RFingAdam/helium-weather-station/assets/DashboardMobile1.PNG

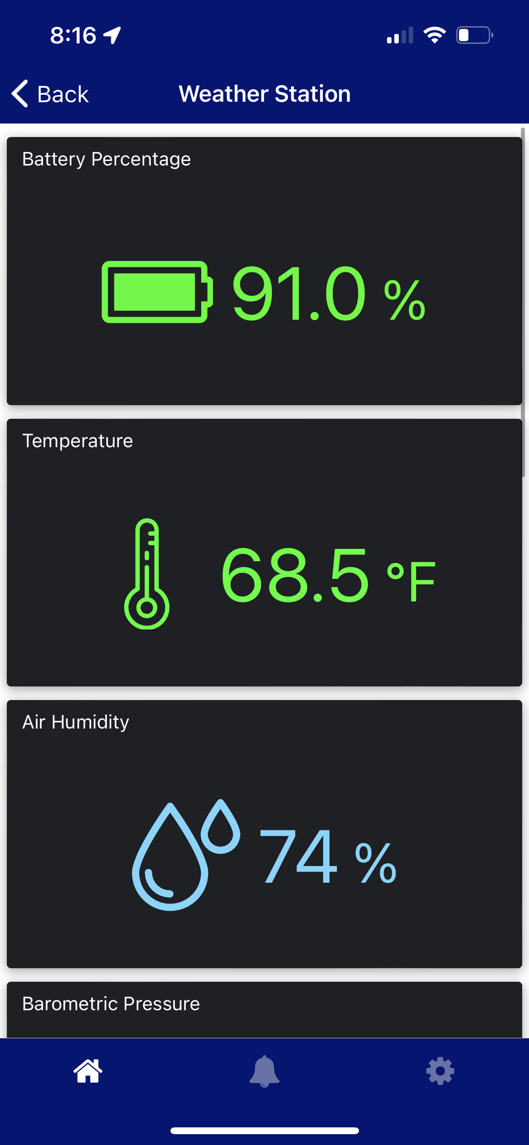
assets/DashboardMobile1.PNG
