RFingAdam/helium-weather-station/assets/DashboardMobile2.PNG

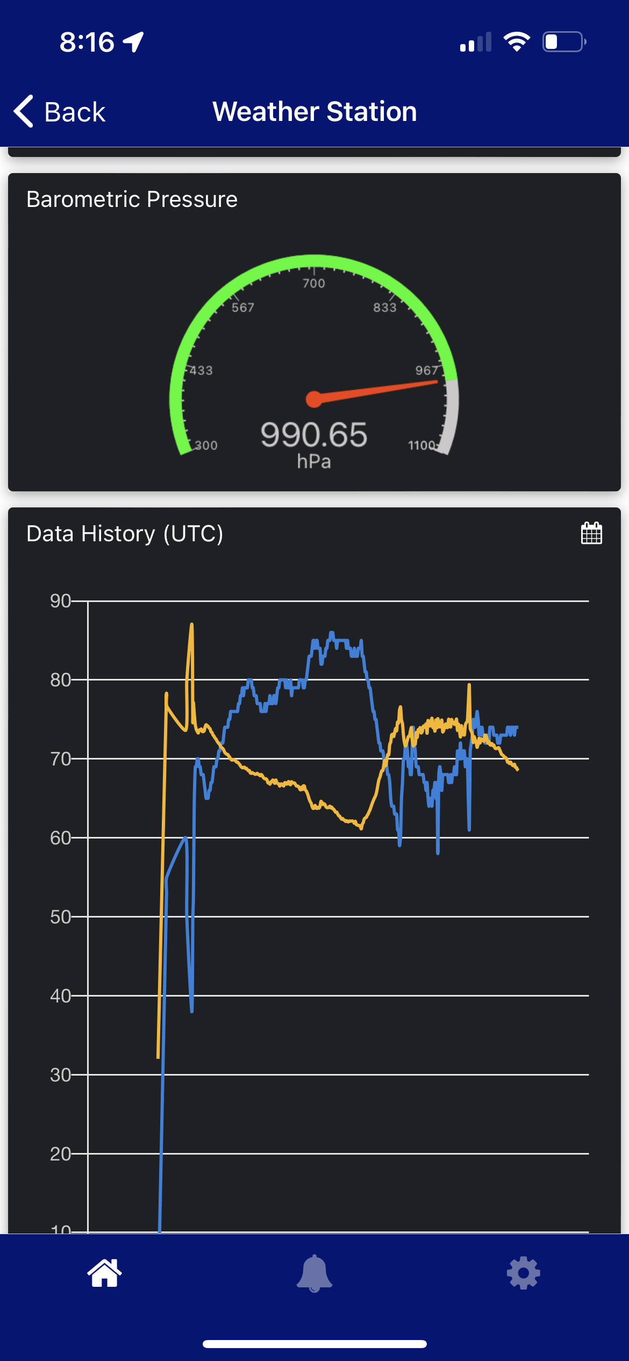
assets/DashboardMobile2.PNG
