RFingAdam/helium-weather-station/assets/finished (2).PNG

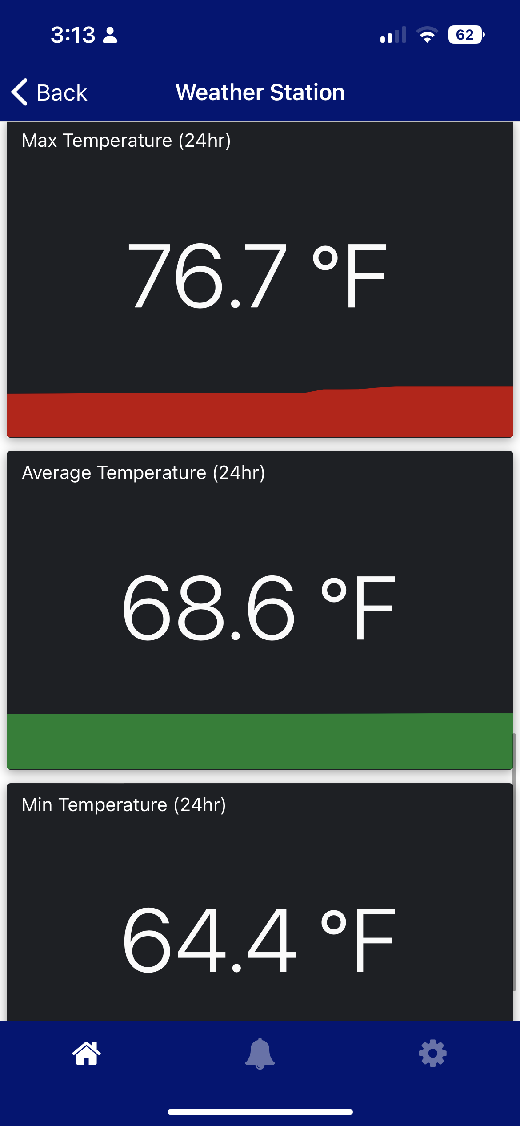
assets/finished (2).PNG
