RFingAdam/helium-weather-station/housing/mini-lora-ws-bracket.step

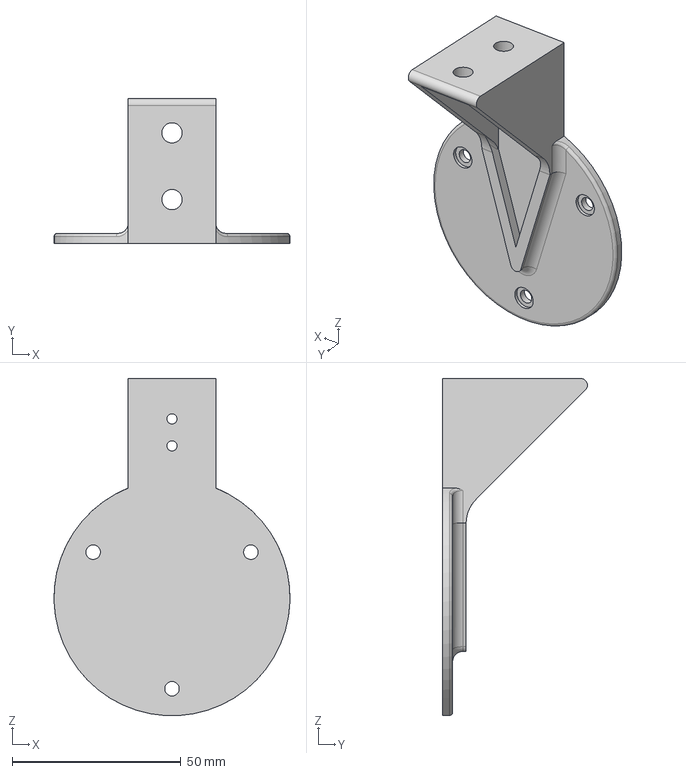
[picture p8: CAD file, 2024-08-08]
housing/mini-lora-ws-bracket.step
70.0 x 43.0 x 99.9 mm
