RFingAdam/helium-weather-station/housing/mini-lora-ws-closedlayer.step

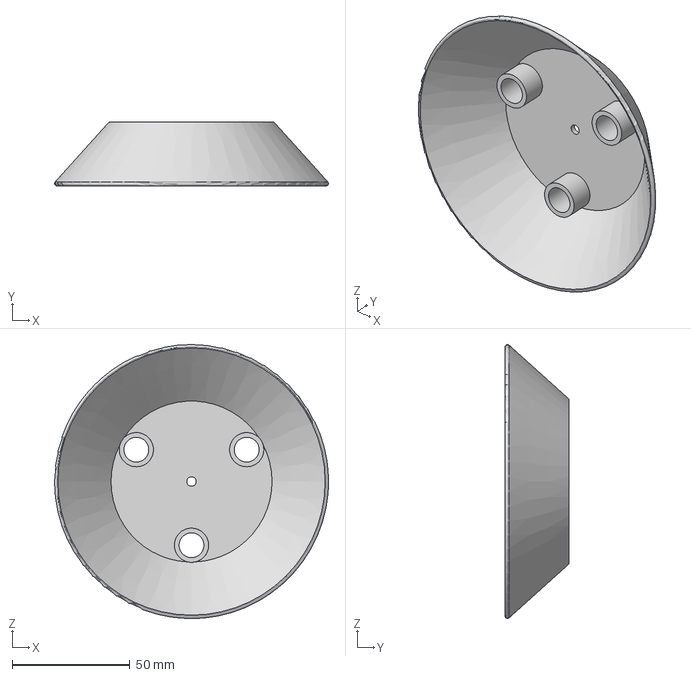
[picture p9: CAD file, 2024-08-08]
housing/mini-lora-ws-closedlayer.step
116.1 x 27.0 x 116.1 mm
