RFingAdam/helium-weather-station/housing/mini-lora-ws-openlayer.step

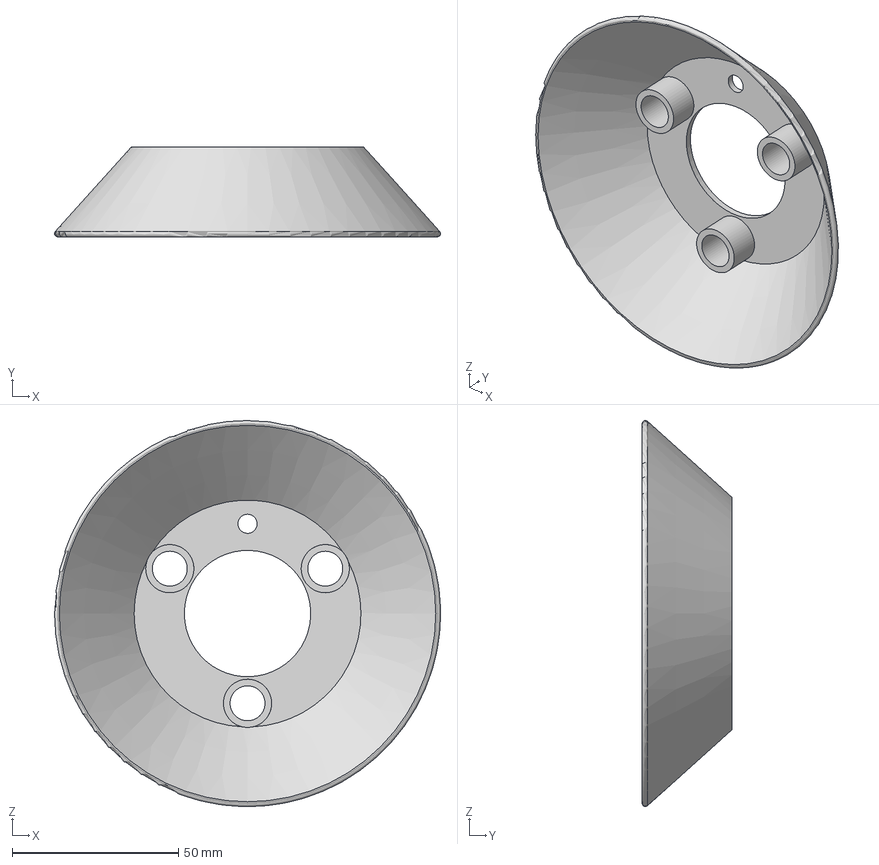
[picture p10: CAD file, 2024-08-08]
housing/mini-lora-ws-openlayer.step
116.1 x 27.0 x 116.1 mm
