RFingAdam/helium-weather-station/housing/mini-lora-ws-base.step

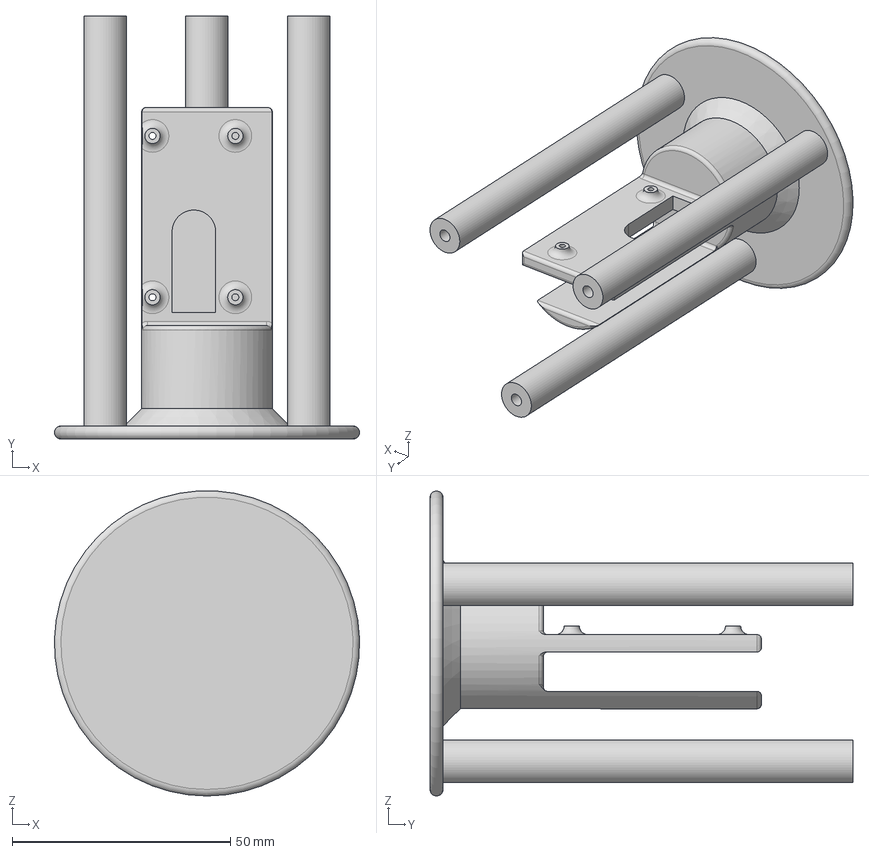
[picture p11: CAD file, 2024-08-08]
housing/mini-lora-ws-base.step
70.0 x 97.0 x 69.9 mm
