RFingAdam/helium-weather-station/housing/mini-lora-ws-solar.step

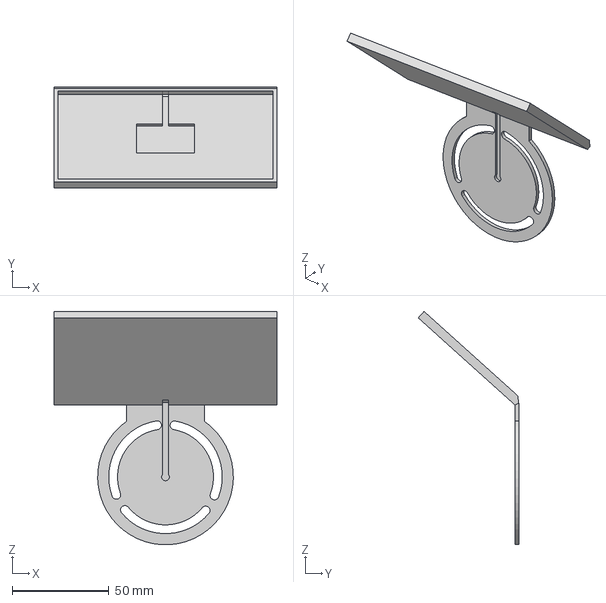
[picture p12: CAD file, 2024-08-08]
housing/mini-lora-ws-solar.step
115.0 x 51.9 x 120.3 mm
