RFingAdam/helium-weather-station/(list of files, cad)

Other CAD files:
housing/mini-lora-ws-top.step
housing/mini-lora-ws-base.stl
housing/mini-lora-ws-bracket.stl
housing/mini-lora-ws-closedlayer.stl
housing/mini-lora-ws-openlayer.stl
housing/mini-lora-ws-solar.stl
housing/mini-lora-ws-top.stl
